klh5/field_monitor/images/DSC_0014.JPG

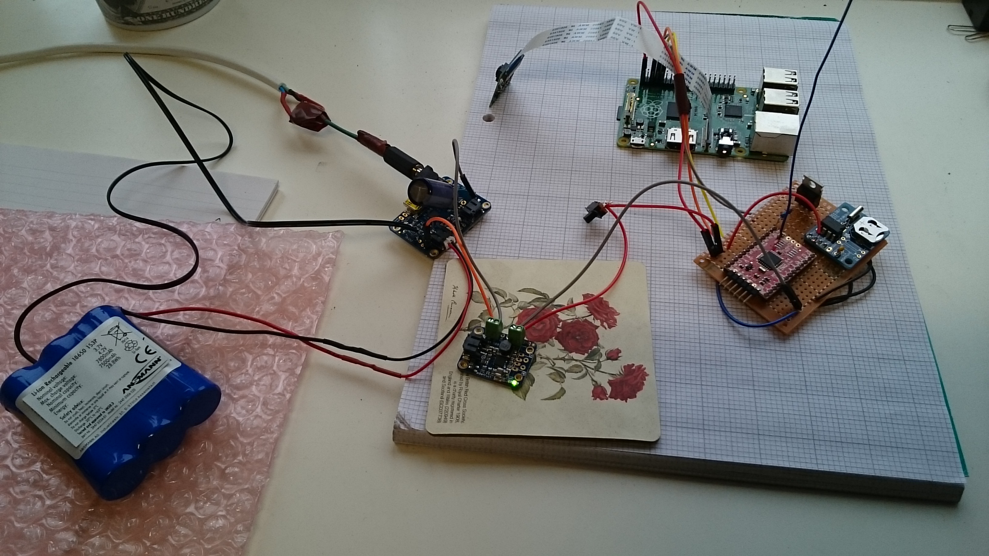
images/DSC_0014.JPG
