klh5/field_monitor/images/DSC_0011.JPG

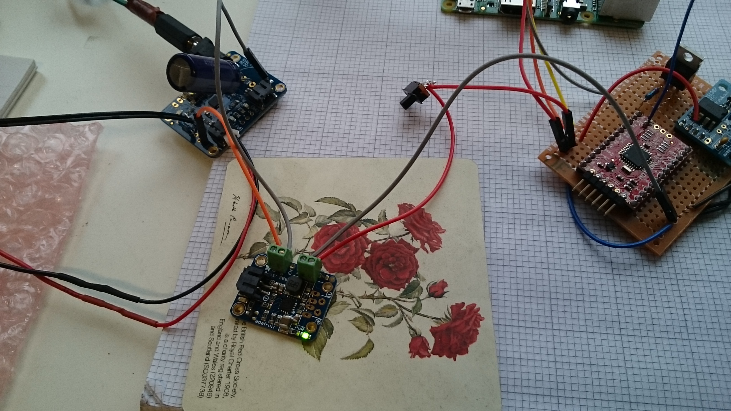
images/DSC_0011.JPG
