klh5/field_monitor/README.md

# field monitor

Code for in-field sensors
