klh5/field_monitor/images/DSC_0009.JPG

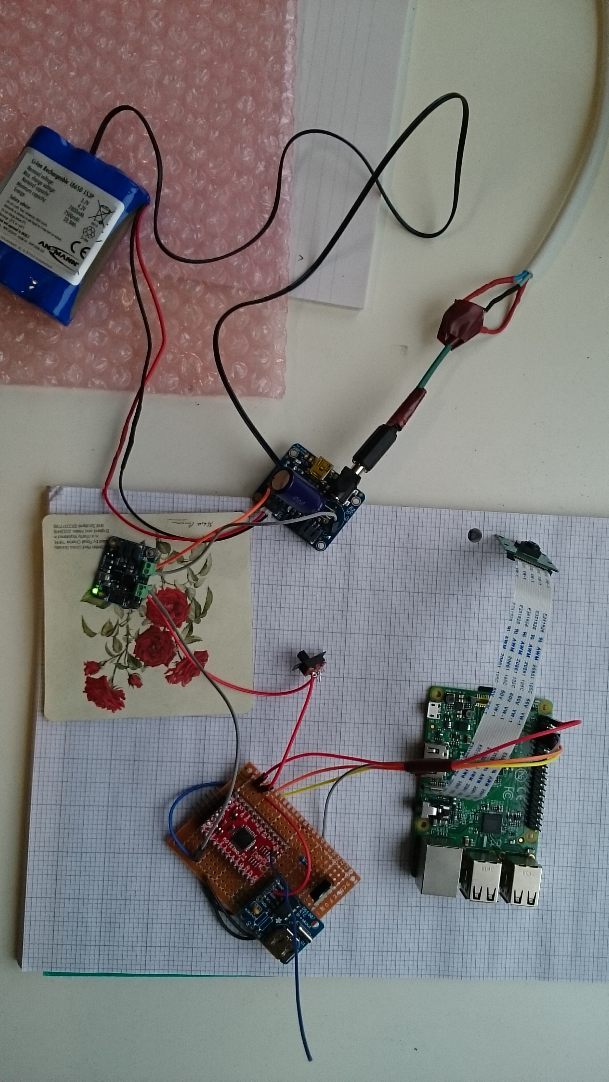
images/DSC_0009.JPG
