klh5/field_monitor/images/DSC_0010.JPG

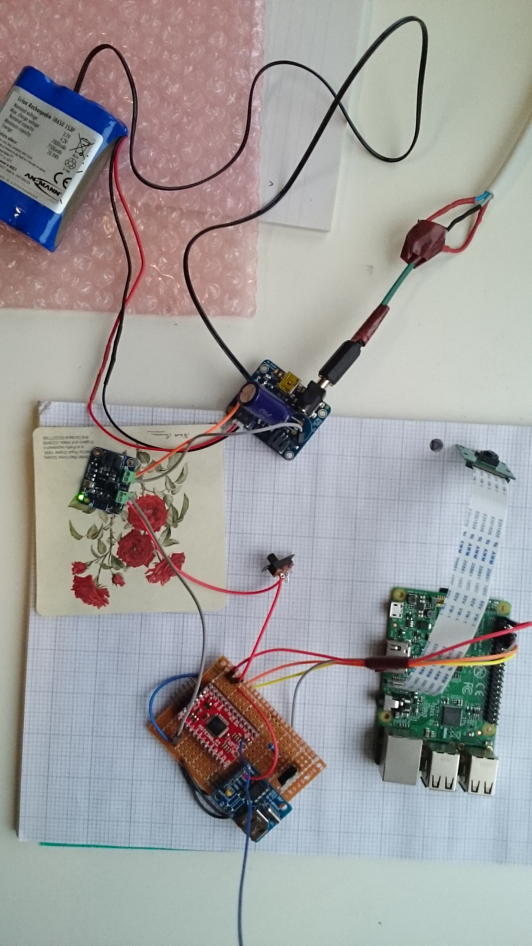
images/DSC_0010.JPG
