klh5/field_monitor/images/DSC_0012.JPG

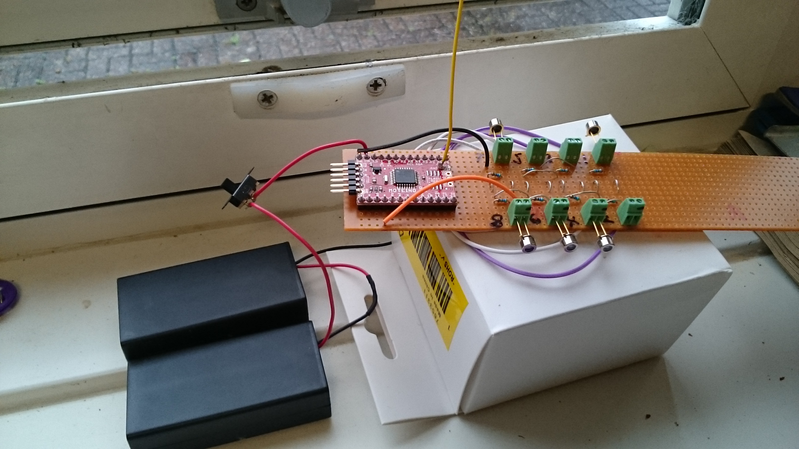
images/DSC_0012.JPG
