klh5/field_monitor/images/DSC_0013.JPG

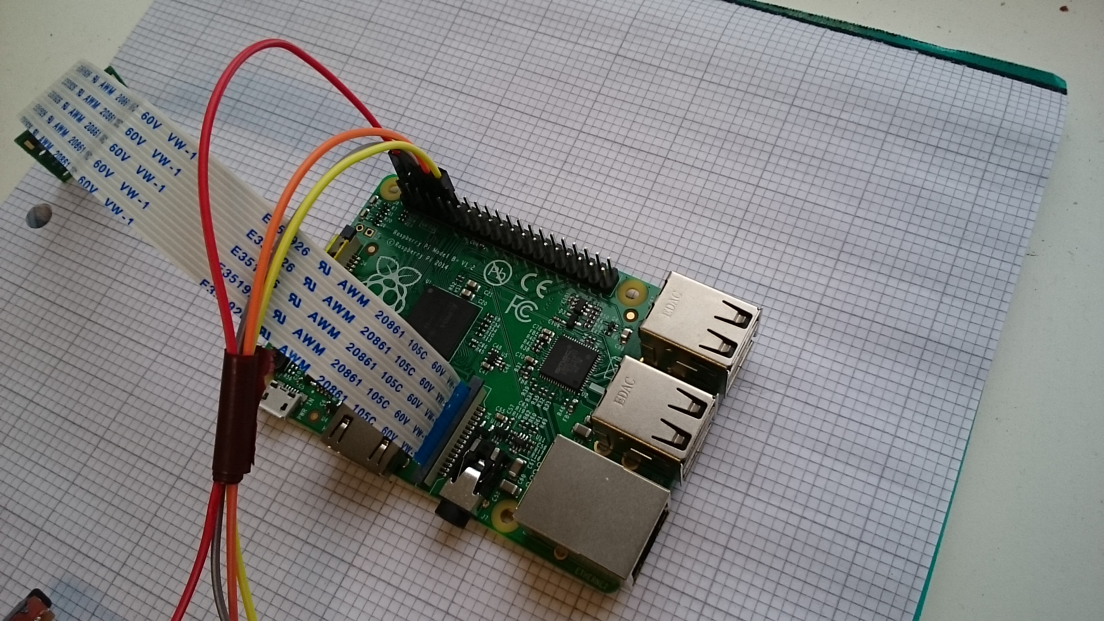
images/DSC_0013.JPG
