klh5/field_monitor/arduino_libraries/RFM69/Examples/SonarMote/SonarMote_lasercut plans_1.75mm acrylic.dxf

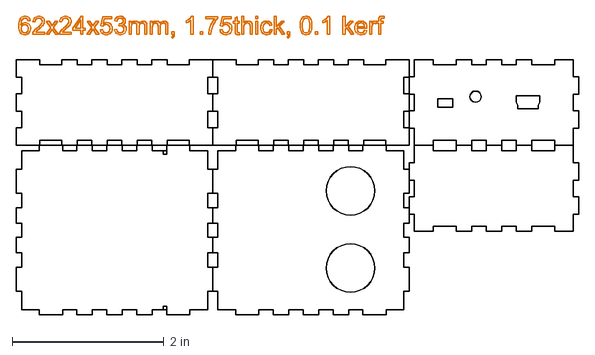
[picture p8: CAD file, 2016-08-05]
arduino_libraries/RFM69/Examples/SonarMote/SonarMote_lasercut plans_1.75mm acrylic.dxf
7.41 x 3.94 in
