klh5/field_monitor/documentation/manual.pdf

Setting up the Raspberry Pi based field sensor monitor August 2016

1

## Contents

1 INTRODUCTION | 3
2 SETUP | 5
3 RETRIEVING DATA | 19

2

## 1 INTRODUCTION

This document describes how to set up and use the field monitoring system based on a Raspberry Pi base station and Moteino/Arduino based loggers. It provides a description of the hardware used and how to set up specific parameters in software, such as logging frequency.
In this document, the term “controller” refers to the Moteino which is attached to the Raspberry Pi. It receives data from “loggers”, which are the independent Moteinos with photodiodes (and/or other sensors) attached. The Raspberry Pi takes pictures and is turned off and off by the controller. The term “base station” refers to the combination of Raspberry Pi and Controller, because they work together.
The network operates on a star topology, with individual battery powered loggers reporting back to a base station. Loggers read from their photodiode arrays only when they are told to by the controller. The controller tells the loggers when to read from their sensors, and also turns the Raspberry Pi on and off. Turning the Pi off when it’s not needed results in a dramatic power saving. Like the loggers, the controller is a Moteino microcontroller with a radio attached. It’s necessary to set up radio parameters so that the right loggers are talking to the right controller. These parameters are set out and explained in this document.
The Raspberry Pi acts as a data logger and camera operator. At each logging interval (which must be a multiple of 5 minutes) it is woken by the controller. The controller sends any data received from the loggers to the Raspberry Pi. Once this data has been received, the Pi captures and saves an image before automatically shutting down. If an ethernet cable is connected, it won’t shut itself down, but power will be cut by the controller after about ten seconds. To work around this, the Pi needs to be powered seperately when retrieving data. This process is also set out in this document.

### 1.1 On Your Computer

### 1.1.1 Development Environment

For uploading code to the controller and loggers, you can use the Arduino IDE (Integrated Development Environment). This is a cross platform IDE (you can download it for Windows as well as Mac and Linux) which can be found at https://www.arduino.cc/en/Main/Software. There is a good overview of how to use the Arduino IDE at https://www.arduino.cc/en/Guide/Environment. When you have Arduino installed, there are a couple of things you need to do before you can upload code. There are some extra bits of code, called libraries, that the field logging system uses. You can download these, but they are included with the files for this project in field monitor/arduino libraries. These need to go in a specific place for the Arduino IDE to find them. For windows, you should have a directory called My Documents/Arduino/libraries. Place all of the folders inside field monitor/arduino libraries into this directory.

3

For Linux, they need to go in /sketchbook/libraries.
You need to restart the Arduino IDE for it to find the libraries.
You also need to make sure you have the right board selected. The Moteino is very similar to the Arduino Uno, so we can use that as our upload target:
- Open the Arduino IDE program
- Go to Tools - Board
- Select Arduino Uno from the list

You also need to select the right port:

- Open the Arduino IDE
- Go to Tools - Port
- Select the port that your Moteino is on. If you’re not sure, unplug the Moteino, and see which one disappears
- If you get a “Not in sync” error when uploading, you’re probably connected to the wrong port

Once these are set up, you can use File - Open to open the sketch you want to edit (in this case, field monitor/controller.ino or field monitor/logger.ino. The big tick at the top of the screen is used to compile to code; it should compile without errors. The arrow is used to upload the code to the target board. When you upload to the Moteino, its onboard LED will flash a few times when uploading, then stop. If it carries on flashing, check out the error codes in section 2.2 to find out why.

### 1.2 Additional hardware

You will need an SD card reader and a computer that either has an SD card port or a USB adapter (Google “usb sd card adapter”). This will work fine for Linux, but not on Windows systems, because the Pi has a Linux filesystem type. If you’re using Windows, you’ll need to find a program that allows you to view ext4 filesystems.
To connect the Moteino to your computer so that you can program it, you will need an FTDI cable like this one http://uk.rs-online.com/web/p/interface-development-kits/0429307/. (http://uk.rs-online.com/web/p/interface-development-kits/0429307/) The cable must have 5V power and 3.3V logic. The Moteino is designed to run at 3.3V, so 5V logic is too high (the power input can be 5V, because this goes through a regulator which lowers it to 3.3V). This connects to the 6-pin header on the Moteino. Make sure that when you plug it in, the black wire (ground) on the cable connects to the GND pin of the header.

Before plugging in the Moteino, it’s a good idea to turn off power from any other sources. You’ll probably get away with not doing this,

4

but it’s good practice. Have a look at the 6-pin header on the Moteino. You can see that at one end, a pin is labelled GND, and at the other, a pin is labelled DTR. Line up the FTDI header so that the black wire is lined up with GND, and the green wire is lined up with DTR, and plug it in. Depending on what code the Moteino is already running, the LED might blink.

## 2 SETUP

### 2.1 Raspberry Pi

The SD card image provided has everything already set up, but there are some more details here if you need to change anything. If you just want to set up a new Pi with the provided image, go to Setting up the Pi: The Easy Way. The Raspberry Pi is set up so that it automatically runs a script when it starts. This script listens for any input from the controller and then captures and saves an image using the camera. Then it shuts down the pi. This script is located in /home/pi/scripts and it runs from /etc/rc.local. Scripts run from rc.local run as the “root” user (similar to Administrators in Windows). You can look at this file by typing cat /etc/rc.local. The Raspberry Pi is turned off and off by the controller; it turns the Pi on, waits for it to complete its tasks, then turns it off. If the Pi detects an Ethernet connection, it won’t shut down after running its script.

### 2.1.1 Setting up a new Pi: The Easy Way

All you need to set up a Raspberry Pi this way is the Pi itself, an SD card (preferably class 10, 8GB or greater) and card reader, the camera module, and an Ethernet cable. This part of the setup assumes that the Pi is not connected to the controller and is being powered through the micro USB port as normal.
There is a file called pi logger.img.zip included in field monitor/raspberry pi. This is an image file, and it’s basically an “image” of a working Pi running our code and with our settings. If we flash this image to a new SD card, it will have everything we need for the Pi to work with no setup. It’s compressed, so you need to unzip it first - this should result in a file called pi logger.img.
In Linux, use the dd tool to flash the new SD card, with the command

dd if=field_monitor/raspberry_pi/pi_logger.iso of=/path/to/new/sdcard

In Windows, follow the instruction from the Raspberry Pi Foundation at https://www.raspberrypi.org/documentation/installation/installing-images/windows.md. (https://www.raspberrypi.org/documentation/installation/installing-images/windows.md) It’s not as hard as it looks! You just need to install a program
called Win32DiskImager, which will allow you to write to the SD card.
If you use an SD card with a capacity greater than 8GB, you will still only
have 8GB of storage unless you expand the partition so that the Pi can access the extra room. You also need to check that the camera module is enabled. To

5

do this, you will need to access the Pi over Ethernet. The image file is already set up to allow you to do this, but you will need to do some setting up on your own computer as well. This process will also be useful later on for downloading data.
The Raspberry Pi image you just flashed is set up with a certain IP address. IP addresses are how computers identify each other over network connections. You’re computer needs to have an IP address which has the same subnet as the Raspberry Pi. IPv4 IP addresses are usually of the format 192.168.1.1. A subnet mask of 255.255.255.0 means that the first three numbers need to match for the computers to talk to each other. The Pi by default has an IP address of 178.122.1.200. So your IP address needs to be the same except for the last number (e.g. 178.122.1.50). The instructions below tell you how to set this up.

For Linux (Ubuntu 14.04):

- Click on the network icon in the menu bar
- Go to Edit Connections
- Click on Add
- Select the Ethernet option
- Give the connection a useful name, like “Pi connect”
- Go to IPv4 settings
- Change the Method to Manual
- Add an address - Address: 178.122.1.50, Netmask: 255.255.255.0, Gateway: 178.122.1.1
- Connect your computer and the Pi with an Ethernet cable, then turn on the Pi
- Your computer should detect the wired connection and connect

You should now be able to log into the Pi by using:

ssh pi@178.122.200

The password is gogerddan.

For Windows 7:

- In field monitor/windows utils, there is a file called putty.exe. Copy this to your computer and double click to run it. It will install a program called Putty
- Plug one end of the Ethernet cable into your computer, and the other end into the Pi

6

- Turn on the Pi
- On Windows, go to Control Panel - Network and Internet - Network and Sharing Center
- The connection to the Pi should show up as an “Unidentified Network” -usually there is a picture of a park bench
- Click on Local Area Connection on the right hand side
- A new window should appear with some details. Click on Properties
- In the list, select Internet Protocol Version 4 (TCP/IPv4)
- With that selected, click Properties
- A new window will open. Select the Use the following IP address option
- Type in these settings - IP Address: 178.122.1.50, Subnet: 255.255.255.0, Gateway: 178.122.1.1
- Leave the DNS server section blank
- Save and exit

Now you can use Putty to connect to the Pi:

- Start Putty
- In Host Name (or IP address): type pi@178.122.1.200
- The Port should be 22
- Click Open. If a warning box comes up, click Yes
- A black terminal will come up - when prompted, enter the password (gogerddan)
- You are now logged in to the Pi

Note: On Windows computers, doing this might stop your computer from connecting properly to other wired connections. If this happens, you will need to reset the settings to Obtain an IP address automatically every time you use a different wired network. You can use something like NetSetMan (http://www.netsetman.com/en/freeware) (http://www.netsetman.com/en/freeware) to manage your connections.

Now that you are logged in to the Pi, type

sudo raspi-config

7

Select the second option in the dialog box, labelled Expand root partition to fill SD card. This will expand the available space to fill the SD card. From the same menu, you can also make sure that the camera module is enabled by selecting Camera. Then select Finish (you don’t need to reboot - the next step will just turn off the Pi).
To turn off the Pi (try not to ever just switch off the power - it can corrupt the SD card), you can type

sudo halt

This will shut down the Pi. After about ten seconds, the Pi will be off, though the red LED will still be on. At this point it is safe to turn off power to the Pi.
Once you have the SD card flashed and expanded, install it in the Raspberry Pi, and connect the camera. There are instructions on how to connect the camera at https://www.raspberrypi.org/documentation/usage/camera/ (just the physical “Connecting the Camera” part - the rest is already set up on the SD card). The software on the Pi is now ready to go.

### 2.1.2 Setting up a new Pi: The Harder Way

If you’re familiar with Linux, the command line and SSH, you can set everything up from scratch. We will set up the Pi to connect via Ethernet to your machine, so you don’t even need an internet connection (this is also useful for downloading data from the Pi when it’s in the field - see later section). This section assumes that you already have a Pi running Raspbian (Jessie or later) which you want to set up for use with this system, and that you have root access.
The first thing to do is to set up the Ethernet connection so that your machine can communicate directly to the Pi. If your Pi is already connected to the internet, this isn’t really necessary, but it does provide another avenue of data collection when the Pi is located remotely. To connect to the Pi this way, your machine and the Pi need to be within the same subnet. The easiest way to do this is to set up static IP adresses on the Pi and on your machine.
To set a static IP on the Pi , you need to mount the SD card in your machine and edit /etc/dhcpcd.conf. Insert the following at the bottom of the file (you can replace the IP address with whatever you prefer, but this document assumes these settings):

interface eth0

static ip_address=178.122.1.200/24 static routers=178.122.1.1
static domain_name_servers=178.122.1.1

Now you need to set up a new ethernet connection on your machine with an IP address within the same subnet as the Raspberry Pi, and log in to the Pi using SSH. For this, you can follow the instruction in section 2.1.1 above. Once you are logged in, check that the camera is enabled. Type:

8

sudo raspi-config

Select the “camera” option. Select “finish” to set the option and reboot. It’s also a good idea to change from the default password if you haven’t already -use the passwd command.
Next, we need to set up the required Python packages. If you have an internet connection, you can just install these via apt-get - the following applies if you only have a direct connection to the Pi, via SD card or Ethernet.
There are seven packages located in field monitor/raspberry pi/packages. To get them onto the Pi, you can just mount the SD card and copy them into a suitable directory to install from (such as ), or you can copy them over the Ethernet connection using Secure Copy (SCP). To use SCP, the command is:

scp path/to/file/being/copied pi@178.122.1.200:/home/pi

The packages need to be installed in the right order, as some depend on others. The command to install the .deb packages is:

sudo dpkg -i <package name>

For the others, navigate into the package directory, e.g.:

cd netifaces-0.10.4

Then install using Python:

sudo python setup.py install

The installation order is:

- libpython2.7-dev
- libpython-dev
- python2.7-dev
- python-dev
- netifaces
- picamera
- piserial

Once all of the packages are installed, you need to upload a Python script to the Raspberry Pi. The script is located at field monitor/raspberry pi/process data.py and controls everything relevant to the Pi’s field monitoring. As with the packages, you can upload this by mounting the SD card or by using SCP. It’s recommended to place it in a directory called /home/pi/scripts. The script will create the directories it needs to store the data, so don’t worry about that unless you are setting up a custom directory structure. If you’re using custom directories, make sure you change all of the paths in process data.py so that your data gets stored properly.
The process data.py script needs execute permissions, so make sure to run:

9

chmod +x process_data.py

We need the Python script to run at boot, so that when the controller turns on the Pi, the Pi automatically picks up data from the controller, captures an image, and shuts itself down. We can do this by running process data.py from /etc/rc.local. Add the following line to /etc/rc.local before exit 0 (remember to change the file path, if it’s not in /home/pi/scripts):

python /home/pi/scripts/process_data.py &

Next there are a couple of things we need to do to allow the Pi to communicate with the controller over serial GPIO. First, edit /boot/cmdline.txt and remove the following:

console=ttyAMA0,115200 kgdboc=ttyAMA0,115200

This will prevent the Pi from sending data over serial when it’s booting. Next, we need to disable the console on the serial port. While logged in to the Raspberry Pi, type:

sudo systemctl disable serial-getty@ttyAMA0.service

Finally, even though we have disabled serial output at boot, there is still a line that prints when the kernel is being uncompressed. To get rid of this,
we can get Raspbian to boot from an uncompressed image. This is a little
tricky, and you can find the original instructions here http://raspberrypi.stackexchange.com/questions/24583/ttyama0-disabled-but-still-shows-one-boot-message. (http://raspberrypi.stackexchange.com/questions/24583/ttyama0-disabled-but-still-shows-one-boot-message) Otherwise, you can follow these instructions:
- SSH into the Pi
- Type the following command (Note: If you’re using an older Raspberry Pi (less than Model 2), replace kernel7 with kernel):
od -A d -t x1 /boot/kernel7.img | grep ’1f 8b 08 00’
- You should see a line that looks like this (example 1):

0017360 1f 8b 08 00 00 00 00 00 02 03 e4 fd 0b 7c 54 d5

Or like this (example 2). Notice the extra 08 at the end:

0017360 00 00 00 00 00 00 00 00 1f 8b 08 00 00 00 00 00

- If your output looks like example 1, the offset is 17360
- If your output looks like example 2, the offset is 17360 + 08, or 17368
- Type:

10

sudo -i

To get an interactive root shell

- Type the following command to create an uncompressed copy of the kernel,
replacing the word OFFSET with the offset number you found above:
dd if=/boot/kernel.img skip=1 bs=OFFSET | gzip -d >/boot/kernel_uncompressed.img
- Now run the following commands to back up the current compressed kernel, and replace it with the uncompressed version:

cd /boot
cp kernel.img kernel_compressed.img
cp kernel_uncompressed.img kernel.img reboot
- If your Pi boots successfully, it has worked

That’s it! Your Pi should now be able to run everything it needs for the field monitor.

### 2.1.3 Images and space

The Raspberry Pi will capture images with a default resolution of 1080x720. These images are about 500kB in size. A 16GB SD card will have about 11GB of free space, so you have room for 20,000 images. If you’re capturing an image every half an hour, that gives you enough space to save images for several years. If you’re capturing an image every five minutes, you only have enough room for a couple of months. Bear in mind that you might need to delete images fairly frequently to make room if you’re using a higher logging frequency (see section 3.4).

### 2.1.4 Editing the Python script

While logged in to the Pi over SSH, you can edit process data.py using a simple text editor called Nano. This is useful if you want to alter any of the parameters used by the Raspberry Pi. The command to edit the file is:

nano scripts/process_data.py

The file will be opened. This is a command line utility, so you can’t use your mouse to move around and select things. Instead you need to use the arrow keys to navigate to where you want to be. You can press CTRL+o to save, and CTRL+x to exit.
Alternatively you can edit the script by inserting the SD card into your computer and navigating to the /home/pi/scripts directory. The process of accessing the SD card is explained in section 3.1.

11

### 2.1.5 Camera parameters

Using the methods in section 2.1.4, you can edit some of the parameters in the Python script running on the Raspberry Pi. You can change the resolution of the images by editing line 85 in the process data.py script. You might also need to change the shutter speed of the camera. By default, this is automatic depending on the amount of light available. You can change it by adding a line of code to field monitor/raspberry pi/process data.py, straight after the line that sets the resolution, like this:

#Set camera resolution

camera.resolution = (1080, 720)

#Set shutter speed

camera.shutter_speed(10000)

The number you provide needs to be in microseconds (so 10000 is 0.1 seconds). To set it back to automatic, put a value of 0.

### 2.2 Logger

The logger is the Moteino with the light sensor array attached. It runs from 4 x AA batteries and has a low power radio to send data back to the controller. The controller that the logger is sending data back to must have the same NETWORK ID as the logger, or they can’t communicate.
When setting up a new logger, there are a few things that you need to change, and a few things that you can change if you want to. As a minimum, you need to:
- Check that the logger is on the right network, so that it can communicate with the right controller
- Check that the logger has the right CONTROLLER ID - this is the LOG-GER ID of the controller it’s sending data back to
- Check that the logger’s LOGGER ID is unique on it’s network

When you apply power to the logger, you shouldn’t see any activity on the LED. If the LED flashes, you have problem. The logger automatically checks some of its parameters to make sure that they aren’t outside the limits. You will see several flashes in quick succession, followed by a two second gap. The number of flashes you see indicates the problem:

- Two flashes - the number of photodiodes is too high (more than 8) or too low (less than 0)
- Three flashes - the network ID is too high (more than 253) or too low (less than 0)

12

- Four flashes - the logger ID is too high (more than 253) or too low (less than 2)
- Five flashes - the maximum number of photodiodes has been changed, and does not equal 8

### 2.2.1 Radio parameters

LOGGER ID The LOGGER ID is the unique number of the logger. All loggers with the same NETWORK ID need to have different LOGGER ID’s. This is partly so that when you look at the resulting data, you will know what logger it came from. It also allows the radios to identify each other, and to prevent clashes between loggers.
The logger ID is transmitted to the controller along with the data from the logger. Because there is a limit to how much data can be transmitted at once, there is a limit to how big the LOGGER ID can be, because it is only allowed to take up one byte, or eight bits. The highest number you can represent with eight bits is 255. So, including zero, we can have up to 256 unique LOGGER ID’s on one network (networks work the same way). One of these numbers (the number 1) is actually taken by the controller, and the number 255 is used as a “broadcast”, meaning that all loggers on the network can see data transmitted to 255.
So, when you are setting up a new logger, set the logger ID to something greater than 1 and less than 255, and make sure that no other loggers with the same NETWORK ID have the same LOGGER ID.

NETWORK ID The NETWORK ID is used to identify which loggers are on the same network, i.e. which loggers can talk to each other. If you have a Raspberry Pi set up in one field, with a controller with a NETWORK ID of 100, all of the loggers that need to talk to that controller must also have a NETWORK ID of 100. If you set up another base station in a different field nearby, you probably don’t want the loggers in the first field to also be transmitting to that controller.
So, each controller has a unique NETWORK ID. Like LOGGER ID’s, NET-WORK ID’s are limited. So the NETWORK ID needs to be between 1 and 254, and all loggers that send data to that controller have the same NETWORK ID as it.

CONTROLLER ID The CONTROLLER ID is used to identify the controller, which acts as a “gateway” to the Raspberry Pi. So, it’s the LOGGER ID of the controller. Make sure that you put the right textitCONTROLLER ID for the controller that the logger is sending to.

FREQUENCY This is just the frequency of the radio chip - 433MHz is within the ISM (Industry, Scientific and Medical) frequency band, which means it is a legal frequency for low power radio communications.

13

ENCRYPTKEY This is an encryption key - only loggers with the same key can undertsand each other’s transmissions. For this reason, like the NET-WORK ID, all loggers that talk to each other (including the controller) must have the same ENCRYPTKEY. It must be 16 characters long. This encryption also means that no one else can pick up packets being sent on your network.

### 2.2.2 Logging parameters

NUM PHOTODIODES This is the number of photodiodes attached to the logger. They will be read from in order, from analog pin 0 to NUM PHOTODIODES-
1. Moteinos only have eight analog pins (A0 to A7), so this number should never
be greater than 8, but it can be less, for example, if you need to use an analog pin
for a different sensor. If you don’t use all of them for the photodiodes, then always pick the highest number analog pin for the other sensor. So, if you want to use a temperature sensor, put it on A7, and then change NUM PHOTODIODES to 7.

### 2.3 Controller

The controller is the Moteino attached to the Raspberry Pi. Most of the parameters for the controller are the same as for the logger. The controller’s LOGGER ID is the logger’s CONTROLLER ID.
Like the logger, the controller will flash to indicate any problems:
- Three flashes - the network ID is too high (more than 253) or too low (less than 0)
- Four flashes - the logger ID is too high (more than 253) or too low (less than 2)
- Five flashes - the maximum number of photodiodes has been changed, and does not equal 8
- Six flashes - the logging frequency isn’t 5, 10, 20, 30 or 0

### 2.3.1 Logging parameters

READ FREQ This is the frequency at which readings should be taken. The logger has no real concept of time - it just wakes up every five minutes to check for any radio packets sent by the controller. So, the logging frequency is only set on the controller. READ FREQ can be 5 (for every five minutes), 10 (for every ten minutes), 20 (for every twenty minutes), 30 (for every half and hour) or 0 (for every hour). If you enter any other number, the controller will flash an error code (see section 2.3).
The controller constantly fetches the time from the RTC. When it sees that the correct logging interval has been reached, it turns the Raspberry Pi on, tells all the loggers to take readings, collects the readings, and sends them to the Pi. The Pi also receives a special flag that tells it when all of the data has been

14 sent. After it receives this flag, it takes a picture, then shuts down. Everything can then sleep until the next logging interval.

MAX PHOTODIODES The logger has a MAX PHOTODIODES as well. It is used to limit the maximum size of the data structure that holds the photodiode readings. This data structure needs to be the same size for both the logger and controller, or data won’t be received by the controller. Even if the logger is using less than eight photodiodes, this number still needs to be eight for both the logger and the controller. Don’t worry if you are using less than eight photodiodes - the number you are actually using is defined by NUM PHOTODIODES.

### 2.4 Putting everything together

### 2.4.1 Connecting the RTC to the controller

The controller has no way of knowing the time by itself. The Raspberry Pi can keep track of time to some extent, but it drifts very quickly when it’s not attached to a proper time source that it can update itself with. Timekeeping will also stop every time we turn the Pi off, so it will very quickly become out of date.
To solve this problem, the controller uses a Real Time Clock chip called the DS1307. This ticks away on its own 3V battery most of the time, and can last years on one coin cell. This allows us to shut down the Pi, and still keep time. The controller just sends the time to the Pi before it sends any data, so that the Pi can store data with the right timestamp. We are using a breakout board from Adafruit which allows easy interfacing with the controller.

Note: The DS1307 needs 5V to wake it up from sleeping so that it can communicate with the controller. But the controller is a 3.3V device, and 5V would fry its I/O pins. When soldering the breakout board, leave out the two 2.2k resistors. This forces the board to communicate using 3.3V instead of 5V.

Once the board is soldered, it needs to be connected to the controller. This is straighforward. Connect the SDA pin of the board to pin A4 of the Moteino, and connect the SCL pin to pin A5 of the Moteino. Connect the GND pin to to the Moteino’s GND, or to circuit ground. The 5V pin needs to be connected to the same power input as the Moteino and Raspberry Pi - this is the 5V output from the PowerBoost, outlined below.
For the full tutorial on soldering the RTC breakout, see https://learn.adafruit.com/adding-a-real-time-clock-to-raspberry-pi/wiring-the-rtc. (https://learn.adafruit.com/adding-a-real-time-clock-to-raspberry-pi/wiring-the-rtc)

### 2.4.2 Setting the time

The DS1307 is not a precision clock. It can drift by up to +/-2 seconds a day (or about a minute a month), which is worsened if the temperature is very variable.

15

So at the very least, you’ll need to set the time just before deploying it. Ideally
you would reset it every few weeks (there is a more accurate clock, called the
ChronoDot, available - see https://www.adafruit.com/product/255).
To set the clock, all you need to do is upload the field monitor/controller/testing/set time.ino script onto the controller Moteino. It will automatically set the time to the time
on your computer. If you press Ctrl+Shift+m, a serial monitor will open and
print the time. Remember to re-upload controller.ino afterwards!

### 2.4.3 Connecting the controller to the Raspberry Pi

To enable the controller and the Pi to communicate, you need to connect the four jumper leads coming from the controller board as follows:

- Find the yellow jumper lead coming from the controller board
- Locate the “RX” pin of the Pi. If you are looking at the Pi with the USB ports closest to you, this is the fifth pin down from the top of the right hand header
- Connect the yellow jumper to the “RX” pin of the Pi
- Find the orange jumper lead coming from the controller board
- Locate the “TX” pin of the Pi. If you are looking at the Pi with the USB ports closest to you, this is the fourth pin down from the top of the right hand header
- Connect the orange jumper to the “TX” pin of the Pi
- Find the red jumper lead coming from the controller board
- Find the “5V” pin of the Pi. If you are looking at the Pi with the USB ports closest to you, this is the first pin on the top of the right hand header
- Connect the red jumper to the “5V” pin of the Pi
- Find the grey jumper lead coming from the controller board
- Find the “GND” pin of the Pi. If you are looking at the Pi with the USB ports closest to you, this is the third pin down from the top of the right hand header
- Connect the grey jumper to the “GND” pin of the Pi

### 2.4.4 Powering the base station

The base station utilises a 3.7V Lithium Ion battery for power storage. This is topped up by two 6V solar panels wired in parallel. They are in parallel so that the amount of current they produce is doubled, but their output voltage is still 6V. You can add more solar panels to this array if the battery is failing to keep up with the power requirements of the project.

16

An Adafruit solar charger breakout (MCP73871) is used to control battery charging. This will maintain maximum current draw from the solar panels and will automatically stop charging when the battery is full. The solar charger is fairly straighforward: The solar panel output goes to DCIN, the battery goes to BATT, and the load (the Raspberry Pi/Moteino circuit) goes to B+ (Not L+ or LOAD. This is so that it only sees the battery voltage, not the solar panel voltage. 6V would be too much for the PowerBoost). If you are soldering one of these from scratch, you will also need to solder in the capacitor.
As well as solar, you can recharge the LiPo with a normal 5V wall plug charger that can output at least 500mA. Unplug the solar panel DC jack and plug the charger into the mini USB port on the solar charger. The green LED will light up when the battery is charged.
Because the battery is only 3.7V, it needs to be boosted up to 5V to power the Raspberry Pi and Moteino. The PowerBoost 500 does this. The output from the solar charger goes to Bat, and the load is connected to 5V. In the current setup, two green screw terminals are used to connect the base station to 5V and the solar charger B+ output to Bat. The negatives are marked with black.
There is a switch on the 5V output so that you can turn off the base station entirely if you need to. This is an optional addition if you are building from scratch, but it’s useful.
Both the Moteino and the Pi are connected to the 5V output of the Power-Boost. However, to save power, the Moteino can turn off the Raspberry Pi. To achieve this, an N-channel MOSFET connects the Pi to ground only when its gate is activated by digital pin 4 of the Moteino. The Moteino can therefore turn the Pi on and off by setting pin 4 to OUTPUT, then setting it HIGH or LOW.
There is information on the solar charger at https://www.adafruit.com/product/390 (https://www.adafruit.com/product/390) and information on the PowerBoost 500 at https://www.adafruit.com/product/1944. (https://www.adafruit.com/product/1944)

### 2.5 Monitoring battery temperature

There is a 10k thermistor (resistance at 25◦C is 10k) attached to the Solar Charger (the long black wire soldered to the THERM pads). This should be placed or secured onto the battery to monitor the battery temperature. If the battery gets too cold (below 0◦C) or too hot (above 50◦C), the charger will stop charging the battery to prevent any damage.
The thermistor is ordered seperately from the Solar Charger so it needs to be soldered in (it’s not polarized). Any 10k thermistor will do, though there is one recommended in the BOM (Bill of Materials).

### 2.5.1 Powering the logger

The logger is powered by 4 x AA NiMH LSD (Low Self Discharge) batteries. This battery pack provides a nominal 4.8V. The Moteino’s regulator needs at

17 least 3.6V, so this gives us plenty of headroom (even when fully discharged at 1V each, the overall voltage will still be high enough at 4V). There is a switch to enable the logger to be turned off.
The battery pack should last from one to six months depending on the logging frequency. You can add a 6V, 0.6W solar panel in parallel with the battery pack to charge the batteries (remember to use a diode so that current doesn’t leak back into the solar panel during the night). This solar panel is small enough that it should trickle charge the batteries without overcharging them.
The batteries can be recharged in a standard NiMH (Nickel Metal Hydride) AA battery charger.

### 2.6 Connecting the photodiodes

The logger is part of a board which contains eight terminal blocks. Simply attached the positive and negative leads of the photodiodes to the right sides of the blocks (the negative side of the block has a black mark). All of the circuitry needed to read from the photodiodes is on the board - don’t worry if you plug them in the wrong way around by accident, they will be fine. The board contains 5.6k resistors. Photodiodes generate current when they detect light. This current flows through the resistor, creating a voltage drop. The logger measures the voltage coming from the resistor. The 5.6k resistor was chosen because it will prevent the output voltage going above the logger’s maximum input of 3.3V, even in very bright sunlight.
For the Hammamatsu G1115 photodiode, the positive leg can be identified as being the one closest to the little tab that sticks out horizontally from the bottom of the housing. There’s also a black mark on that side if you look at the top of the photodiode.

### 2.7 Placement

The controller and loggers communicate best when their antennae are perpendicular to ground and as straight as possible. If they can’t be straight (i.e. to fit inside an enclosure), the signal strength will be reduced. Also, the more material is between them, the weaker the signal (plants contain a lot of water, and water isn’t good for radio signals). Anything that contains metal, such as vehicles, could easily block the signals. If you’re frequently getting a low RSSI (see section 3.3), you might need to move your logger and controller closer together. Raising them off the ground or just out of the plant canopy will help. As the base station is solar powered, make sure it’s placed somewhere that will get good sunlight year round. You can always add another (6V, 2W) solar panel in parallel to produce more current. Remember to add a diode so that current can’t leak back into the solar panel at night.

18

## 3 RETRIEVING DATA

At some point you will want to see the data that the Pi has been collecting. It’s a good idea to do this at least once during setup, to check that everything is working properly (i.e. if you want to log every 15 minutes, check after 15 minutes that at least one set of data has been recorded). There are two ways to fetch the data from the Pi. Both involve some disruption of data logging.

If you accidentally delete the data folder, your data will be lost -there’s no Recycle Bin. The folder structure will be recreated by the script the next time it runs.

### 3.1 Copying from the SD card

The Pi’s filesystem is a Linux filesystem. This means that Windows computers won’t be able to read it. But, you can use a Linux computer to copy the data directly from the SD card:

- Wait until the Pi is off - when it’s not logging, none of its LED’s will be lit
- Remove the red jumper wire from the Raspberry Pi - we don’t want it turning on without an SD card
- Remove the micro SD card from the Pi. It’s located on the opposite side to the USB/Ethernet ports. If you depress it once (gently) it will pop out
- Insert the micro SD card into an SD card adapter or micro SD to USB (like this one https://www.amazon.co.uk/Memwah-Micro-SD-Card-Reader/dp/B004WFT762 (https://www.amazon.co.uk/Memwah-Micro-SD-Card-Reader/dp/B004WFT762)
- Plug the adapter into your computer/laptop
- The SD card will be mounted like a normal USB stick or external drive. It will appear as two drives - pick the largest one
- Find the directory called /home/pi/data
- Copy the directory to your computer
- Unmount/eject the card, and put it back in the Pi. Replace the red power wire

Note that this will only work with Linux. If you need to do this in Windows, you need to find a utility that can read ext4 formatted filesystems.

19

### 3.2 Copying over wired connection

The second method involves connecting to the Pi over SSH as described in section 2.1.1. If you haven’t done this yet, you will need to follow the instructions for setting up a new connection within the same subnet as the Raspberry Pi. This method will only work if the Pi can be powered seperately from the controller. This is because the controller is set up to cut power to the Pi after a certain length of time. So, this method is best if you have retrieved the Pi and have it in the office, or if you can connect a portable power supply to the Pi (like a power pack for a mobile phone). A 5V, 2A power supply is best (such as http://uk.rs-online.com/web/p/power-banks/7757517/).
The good thing about this system is that if you can do it between logging intervals, you won’t lose any data. You can also use this method to quickly check that the Pi is logging, without having to remove the SD card or copy any data.

If the system is still logging: Wait until it is off first - no LED’s should be lit. Remove the red jumper wire coming from the controller. You can leave the other three wires connected. Now connect your laptop to the Pi with the Ethernet cable, and connect the seperate power to the Pi through the micro USB port.

If the system is not logging: Make sure that the controller board is switched off with the slide switch. Now connect the Ethernet cable between your computer and the Pi, and connect the seperate power supply to the Pi through the micro USB port.

You can now log in to the Pi using SSH, and proceed to fetch the data:

For Linux:

Once you are logged in, you can fetch the data with the following command (data is the directory we want to copy, and assuming you are using the IP address suggested in section 2.1.1):

sudo scp -rp data user@178.122.1.50:/place/to/put/data

Once you have downloaded the data, you can turn the Pi off with:

sudo halt

It’s important to always turn off the Pi after the data transfer, or logging won’t restart.

For Windows 7:

20

For Windows, you need to install a utility called WinSCP (Note: If you
haven’t installed Putty, WinSCP won’t install. Install field monitor/windows utils/putty.exe first). This will allow you to easily download files from the Pi:
- In field monitor/windows utils, there is a file called WinSCP-5.9-Setup.exe.
Copy this to your computer and double click to run it. It will install a program called WinSCP
- Once it has installed, open WinSCP
- Click on New Site
- The File protocol should be STFP
- In Host name put 178.122.1.200
- The Port number should be 22
- In User name type pi and in Password type gogerddan
- Click Login
- If a warning pops up, click Yes
- The Raspberry Pi’s file structure will appear in the right hand pane. Your computer’s file structure is in the left hand pane
- In the left hand pane, navigate to the directory on your computer that you want to download the data to (it defaults to My Documents
- Select the data folder in the right hand (Pi) pane so that it’s highlighted
- Click Download
- In the popup box, click OK
- The Data folder will be downloaded to the location you selected

Once you have downloaded the data, you can turn off the Pi:

- In WinSCP, go to Commands - Open Terminal
- In the Enter command field, type sudo halt
- Click Execute
- The Pi will shut down

If the system is still logging, disconnect the Ethernet cable, remove the seperate micro USB power source and replace the red jumper wire.

21

### 3.3 Understanding the data

In the /home/pi/data directory, you will see another directory called images, as well as two files, log.txt and data.csv. The images directory contains all of the images captured by the Raspberry Pi. They are named with the timestamp of when they were taken, so you can easily identify their correct order. The log.txt file is a log produced by the Python script. It will contain some basic information about any errors the script encountered; so take a look at this if there have been any problems with the logging.
The third item, data.csv, is a CSV file of all of the data from the loggers.
The data is recorded in the following format:

SENDER_ID NETWORK_ID LIGHT_1 LIGHT_2 LIGHT_3 LIGHT_4 LIGHT_5 LIGHT_6 LIGHT_7 LIGHT_8 RSSI

The SENDER ID identifies which logger the data is from - it’s the ID you
would have set in the code when you uploaded logger.txt to the logger. The
NETWORK ID identifies which network the logger is on. This is followed by the eight light readings: The photodiodes are read from in order, from pin A0 to pin A7. So, the reading from the photodiode attached to pin A7 will be at LIGHT 8.
The final value, RSSI (Received Signal Strength Indicator), is a number that shows the strength of the signal from the logger. The higher the number the better the signal (it will always be negative - usually never higher than -25). If this number is really low, below -90, the logger might be struggling to send data back to the controller.

### 3.4 Deleting data

At some point you’ll probably need to delete some of the data on the Raspberry Pi. This is easy to do with an Ethernet connection. To remove all of the data (don’t worry, the Python script will recreate the data directory next time it runs), you can type:

sudo rm -r data

To remove just one file:

sudo rm file_name

To navigate to the images directory and delete all images:

cd data/images
sudo rm *.jpg

You can also use WinSCP to delete files and folders, if you’re using Windows.

22
