klh5/field_monitor/schematic/field_monitor/field_monitor.sch

## EAGLE design schematic/field_monitor/field_monitor.sch (2016-08-02)

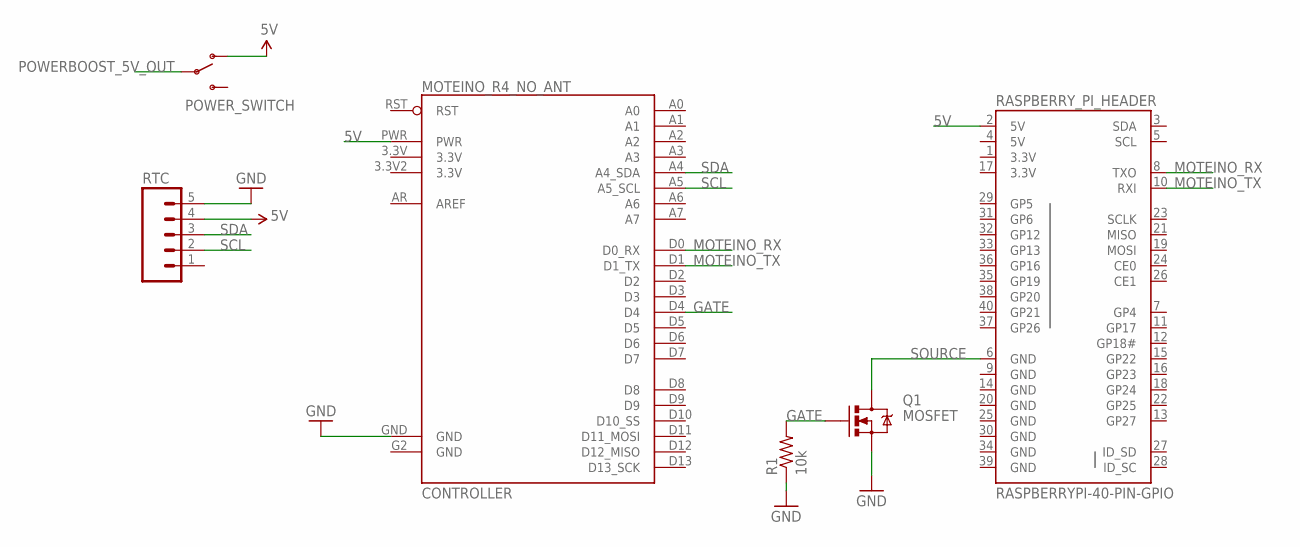
[picture p9: schematic field_monitor.sch]

Parts:
CONTROLLER: MOTEINO_R4_NO_ANT
POWER_SWITCH: SWITCH-SPDTPTH; SWITCH-SPDT
Q1: MOSFET; TO220V
R1: 10k; AXIAL-0.4
RASPBERRY_PI_HEADER: RASPBERRYPI-40-PIN-GPIO; 2X20-SHROUDED
RTC: M05PTH; 1X05

Connections:
5V: CONTROLLER.PWR, POWER_SWITCH.1 (O), RASPBERRY_PI_HEADER.2 (5V), RTC.4
GATE: CONTROLLER.D4, Q1.1 (G), R1.P$2 (2)
GND: CONTROLLER.GND, Q1.3 (S), R1.P$1 (1), RTC.5
MOTEINO_RX: CONTROLLER.D0 (D0_RX), RASPBERRY_PI_HEADER.8 (TXO)
MOTEINO_TX: CONTROLLER.D1 (D1_TX), RASPBERRY_PI_HEADER.10 (RXI)
POWERBOOST_5V_OUT: POWER_SWITCH.2
SCL: CONTROLLER.A5 (A5_SCL), RTC.2
SDA: CONTROLLER.A4 (A4_SDA), RTC.3
SOURCE: Q1.2 (D), RASPBERRY_PI_HEADER.6 (GND)
