klh5/field_monitor/schematics/logger/logger.sch

## EAGLE design schematics/logger/logger.sch (2016-08-05)

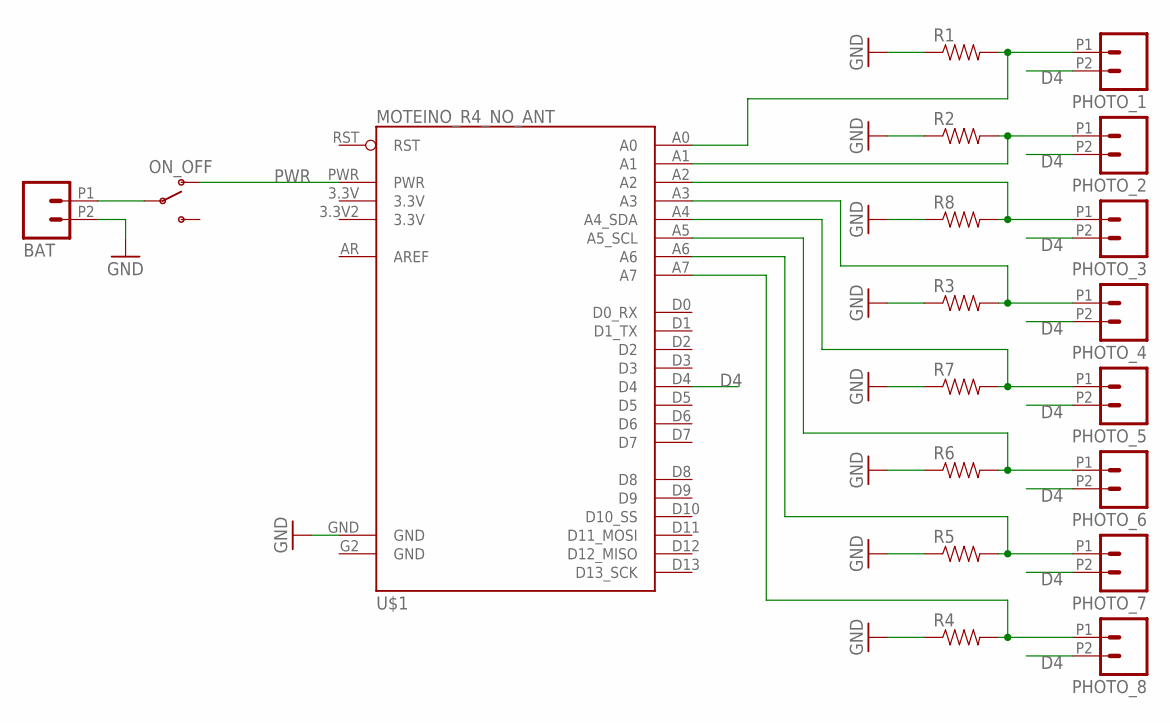
[picture p10: schematic logger.sch]

Parts:
BAT: M022.54MM_SCREWTERM; 1X02_2.54_SCREWTERM
ON_OFF: SWITCH-SPDTPTH; SWITCH-SPDT
PHOTO_1, PHOTO_2, PHOTO_3, PHOTO_4, PHOTO_5, PHOTO_6, PHOTO_7, PHOTO_8: M022.54MM_SCREWTERM; 1X02_2.54_SCREWTERM
R1, R2, R3, R4, R5, R6, R7, R8: RESISTORPTH-1/4W; AXIAL-0.4
U$1: MOTEINO_R4_NO_ANT

Connections:
D4: PHOTO_1.P2 (2), PHOTO_2.P2 (2), PHOTO_3.P2 (2), PHOTO_4.P2 (2), PHOTO_5.P2 (2), PHOTO_6.P2 (2), PHOTO_7.P2 (2), PHOTO_8.P2 (2), U$1.D4
GND: BAT.P2 (2), R1.P$1 (1), R2.P$1 (1), R3.P$1 (1), R4.P$1 (1), R5.P$1 (1), R7.P$1 (1), R8.P$1 (1), U$1.GND
unnamed: PHOTO_1.P1 (1), R1.P$2 (2), U$1.A0
unnamed: PHOTO_2.P1 (1), R2.P$2 (2), U$1.A1
unnamed: PHOTO_3.P1 (1), R8.P$2 (2), U$1.A2
unnamed: PHOTO_4.P1 (1), R3.P$2 (2), U$1.A3
unnamed: PHOTO_5.P1 (1), R7.P$2 (2), U$1.A4 (A4_SDA)
unnamed: BAT.P1 (1), ON_OFF.2
unnamed: PHOTO_8.P1 (1), R4.P$2 (2), U$1.A7
unnamed: PHOTO_7.P1 (1), R5.P$2 (2), U$1.A6
unnamed: PHOTO_6.P1 (1), R6.P$2 (2), U$1.A5 (A5_SCL)
PWR: ON_OFF.1 (O), U$1.PWR
