klh5/field_monitor/(commit log)

2016-08-02 Adding schematic files
    [field_monitor.sch]
2016-08-02 Adding basic components to schematic
    [field_monitor.sch]
2016-08-02 Added RTC to schematic
    [field_monitor.sch]
2016-08-03 Added LED flashes to indicate problems
    [controller.ino, logger.ino]
2016-08-04 Adjusted timings; Added mosfet test script
2016-08-04 Fixed wrong pin output
    [test_mosfet.ino]
2016-08-04 Fixed LED indicator
2016-08-05 Adding schematic for logger
    [base_station.sch, logger.sch]
2016-08-05 Adding Arduino libraries
    [SonarMote_lasercut plans_1.75mm acrylic.dxf]
2016-08-05 Changed photodiode power supply
    [logger.sch]
2016-08-10 Lots of bug fixes
    [controller.ino, logger.ino]
2016-08-11 Added a couple of sections to documentation
2016-08-15 Adding battery charging info
